tin0819tin/Social-Distance-Machine/esp32-wroom32.png

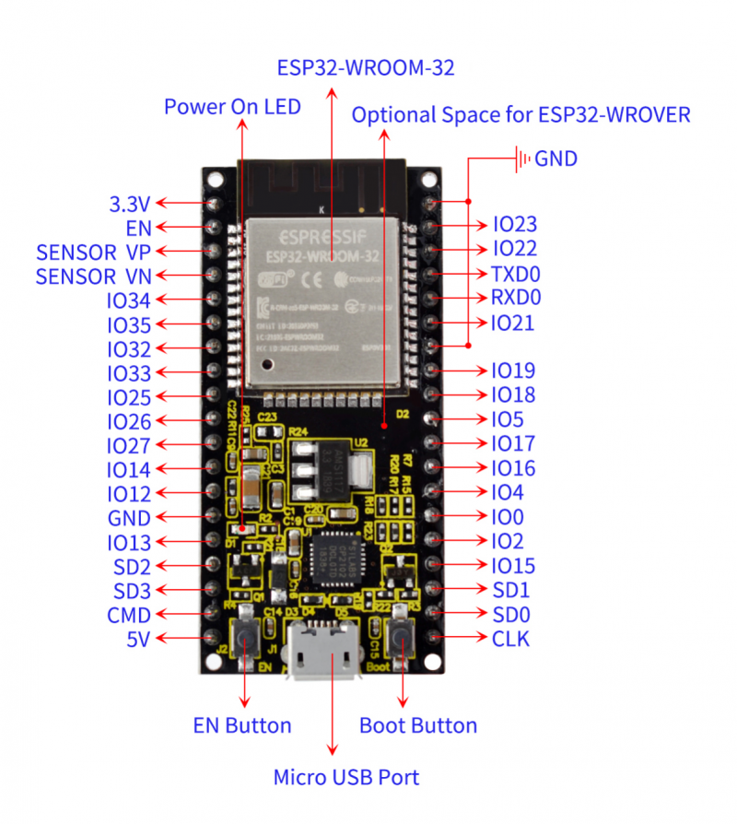
esp32-wroom32.png
