tin0819tin/Social-Distance-Machine/Social Distance Machine/master_slave/master_slave.ino

/*
  Rui Santos
  Complete project details at https://RandomNerdTutorials.com/esp-now-esp32-arduino-ide/
  
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
  The above copyright notice and this permission notice shall be included in all
  copies or substantial portions of the Software.
*/

#include "BluetoothSerial.h"

#if !defined(CONFIG_BT_ENABLED) || !defined(CONFIG_BLUEDROID_ENABLED)
#error Bluetooth is not enabled! Please run `make menuconfig` to and enable it
#endif

#include <esp_now.h>
#include <WiFi.h>

// Structure example to receive data
// Must match the sender structure
typedef struct struct_message {
    char a[32];
    int b;
    float c;
    String d;
    bool e;
} struct_message;

// Create a struct_message called myData
struct_message myData;

int fanPin = 12;
int buzzPin = 13;

//for bluetooth
BluetoothSerial SerialBT;

// callback function that will be executed when data is received
void OnDataRecv(const uint8_t * mac, const uint8_t *incomingData, int len) {
  memcpy(&myData, incomingData, sizeof(myData));
  Serial.print("Bytes received: ");
  Serial.println(len);
  Serial.print("Char: ");
  Serial.println(myData.a);
  Serial.print("Int: ");
  Serial.println(myData.b);
  Serial.print("Float: ");
  Serial.println(myData.c);
  Serial.print("String: ");
  Serial.println(myData.d);
  Serial.print("Bool: ");
  Serial.println(myData.e);
  Serial.println();
}
 
void setup() {
  pinMode(fanPin, OUTPUT);
  digitalWrite(fanPin, LOW);
  pinMode(buzzPin, OUTPUT);
  digitalWrite(buzzPin, LOW);
  // Initialize Serial Monitor
  Serial.begin(115200);

  //for bluetooth
  //Serial.begin(115200);
  SerialBT.begin("ESP32test"); //Bluetooth device name
  Serial.println("The device started, now you can pair it with bluetooth!");
  
  // Set device as a Wi-Fi Station
  WiFi.mode(WIFI_STA);

  // Init ESP-NOW
  if (esp_now_init() != ESP_OK) {
    Serial.println("Error initializing ESP-NOW");
    return;
  }
  
  // Once ESPNow is successfully Init, we will register for recv CB to
  // get recv packer info
  esp_now_register_recv_cb(OnDataRecv);
}
 
void loop() {
  if (Serial.available()) {
    SerialBT.write(Serial.read());
  }
  if (SerialBT.available()) {
    data1 = SerialBT.read()
    Serial.write(data1);
    if(data1 == '1')
    {
      digitalWrite(fanPin, HIGH);
    }
    else if(data1 == '0')
    {
      digitalWrite(fanPin, LOW);
    }
  }
  if(myData.e == true)
  {
    //close and open
    digitalWrite(fanin, HIGH);
    delay(500);
    digitalWrite(fanPin, LOW);
  }
  //delay(20);
}
